MiGen97/DailyQuotes/(commit log)

2020-01-24 Added light sleep when the qoute is printed on display
2020-01-24 Added the electrical circuit
2020-01-24 Added the circuit image in README
2020-01-25 Fixed the white display after LightSleep
    [DailyQuotes.ino]
2020-01-27 Fixed the deepSleep time
    [DailyQuotes.ino]
2020-02-12 Improved the circuit picture
2020-02-12 Added the electrical circuit image
